feiwtyro/FEIW-multi_color/README.md

# FEIW-multi_color
适用于klipper固件近程挤出3D打印机的四色换色器
多色原理
使用双电机分别步骤耗材选择以及耗材加载。通过klipper宏进行耗材选择 耗材加载 耗材退出等功能。
使用过程中需要保存T0耗材位为完全松开状态（最新版本已增加初始反馈）
