feiwtyro/FEIW-multi_color/FEIW-多色实验版本/!物料清单.xlsx

序号 | 名称/型号 | 数量 | 备注
1 | 608ZZ轴承 | 2
2 | U623ZZ轴承 | 4 | 注意为3x10x3规格的
3 | φ3x8轴 | 4 | 没有的话剪断m3螺丝应该也可以用
4 | M3x25螺丝 | 8
5 | 耗材挤出轮 | 2 | 40齿makerbot挤出轮 φ12x11
6 | 微动开关 | 2 | 1A型 无杆
-- | M3螺母 | 2 | 挤出机固定到型材的座子用
-- | 螺丝 |  | 微动固定螺丝m2 型材固定螺丝m5
