feiwtyro/FEIW-multi_color/FEIW-多色实验版本/模型/多色指针.STEP

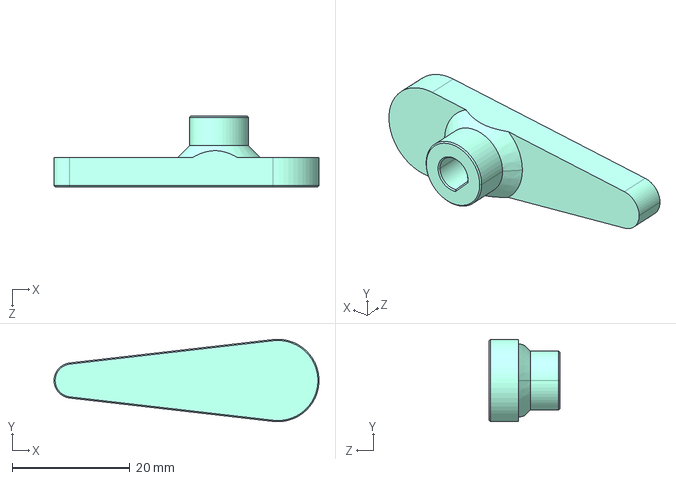
[picture p9: CAD file, 2023-04-29]
FEIW-多色实验版本/模型/多色指针.STEP
45.0 x 14.0 x 12.0 mm
