feiwtyro/FEIW-multi_color/FEIW-多色实验版本/模型/滑块-v1.2  x2.STEP

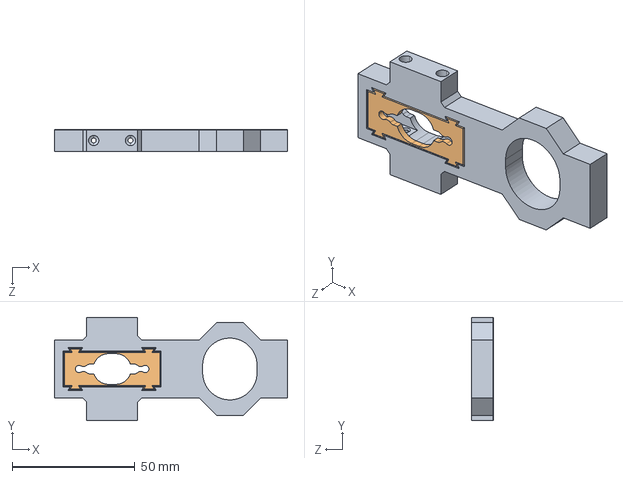
[picture p10: CAD file, 2023-04-29]
FEIW-多色实验版本/模型/滑块-v1.2 x2.STEP
95.0 x 42.0 x 9.00 mm
