feiwtyro/FEIW-multi_color/FEIW-多色实验版本/模型/外壳-v1.STEP

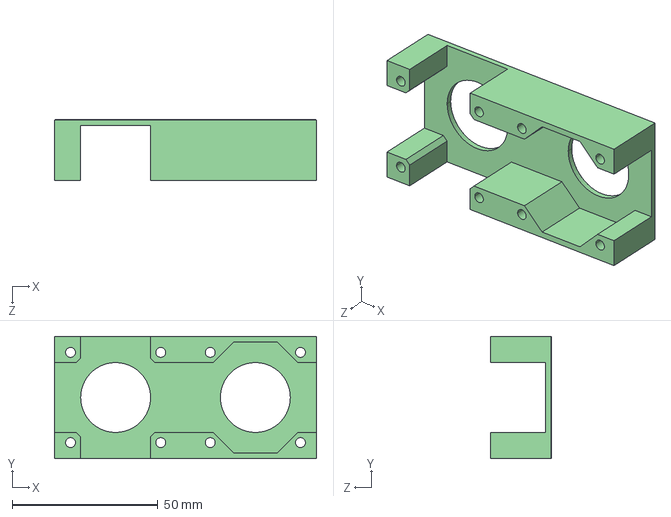
[picture p11: CAD file, 2023-04-29]
FEIW-多色实验版本/模型/外壳-v1.STEP
90.0 x 42.0 x 21.0 mm
