feiwtyro/FEIW-multi_color/FEIW-多色实验版本/模型/盖板.STEP

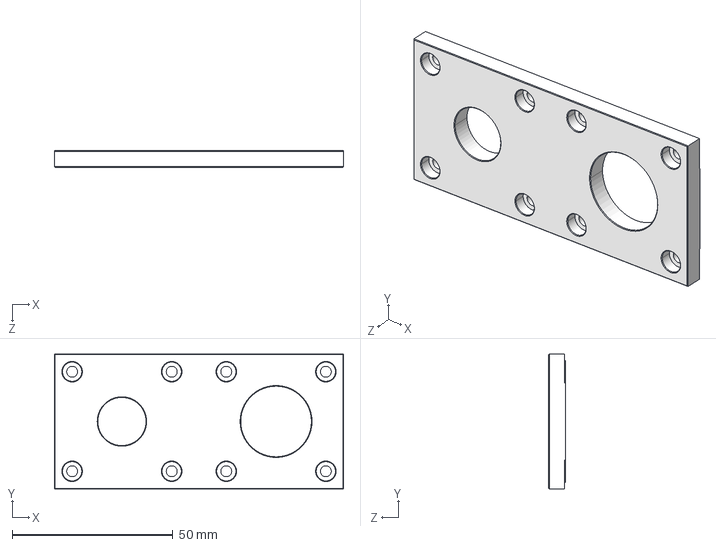
[picture p12: CAD file, 2023-04-29]
FEIW-多色实验版本/模型/盖板.STEP
90.0 x 42.0 x 5.20 mm
