feiwtyro/FEIW-multi_color/FEIW-多色实验版本/模型/偏心盘  x2.STEP

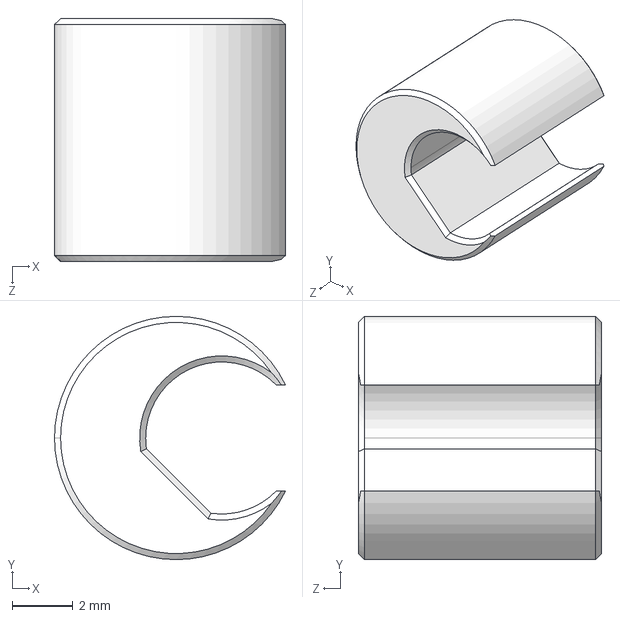
[picture p13: CAD file, 2023-04-29]
FEIW-多色实验版本/模型/偏心盘 x2.STEP
7.60 x 8.00 x 8.00 mm
