feiwtyro/FEIW-multi_color/FEIW-多色实验版本/模型/4in1-v1.2.STEP

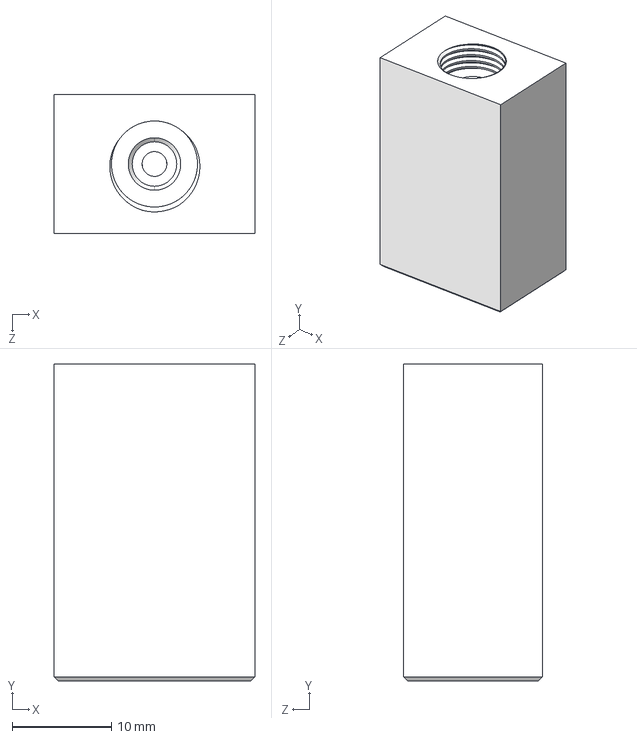
[picture p14: CAD file, 2023-04-29]
FEIW-多色实验版本/模型/4in1-v1.2.STEP
20.3 x 32.0 x 14.0 mm
