feiwtyro/FEIW-multi_color/FEIW-多色实验版本/模型/固定到型材.STEP

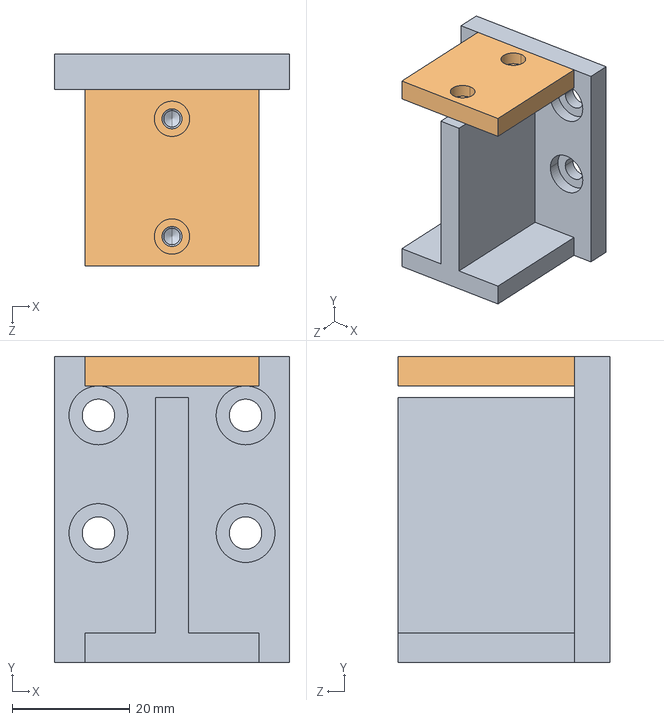
[picture p15: CAD file, 2023-04-29]
FEIW-多色实验版本/模型/固定到型材.STEP
40.0 x 52.0 x 36.0 mm
