feiwtyro/FEIW-multi_color/(commit log)

2023-05-06 更新切片Gcode中的bug
2023-05-17 更新教程文件
2023-05-17 更新耗材更换gcode
2023-05-17 更新配置文件
    [-more_extruders_v2.5.cfg]
2023-07-19 Add files via upload
    优化调试步骤和逻辑
